Patokyo/blackjack-keychain/hardware/fabrication/blackjack-keychain.csv

Id | Designator | Footprint | Quantity | Designation | Supplier and ref
1 | C1, C2, C3 | C_1206_3216Metric_Pad1.33x1.80mm_HandSolder | 3 | 100nf
2 | C4 | C_1206_3216Metric_Pad1.33x1.80mm_HandSolder | 1 | 10uf
3 | D1 | LED_1210_3225Metric_Pad1.42x2.65mm_HandSolder | 1 | pair
4 | D2 | LED_1210_3225Metric_Pad1.42x2.65mm_HandSolder | 1 | soft
5 | D3 | LED_1210_3225Metric_Pad1.42x2.65mm_HandSolder | 1 | win
6 | D4 | LED_1210_3225Metric_Pad1.42x2.65mm_HandSolder | 1 | lose
7 | D5 | LED_1210_3225Metric_Pad1.42x2.65mm_HandSolder | 1 | push
8 | D6 | LED_1210_3225Metric_Pad1.42x2.65mm_HandSolder | 1 | right
9 | D7 | LED_1210_3225Metric_Pad1.42x2.65mm_HandSolder | 1 | wrong
10 | J1 | USB_C_Receptacle_GCT_USB4125-xx-x-0190_6P_TopMnt_Horizontal | 1 | USB_C_Receptacle_PowerOnly_6P
11 | J2 | ISP_2x03_Pads | 1 | Conn_02x03_Odd_Even
12 | Q1, Q2, Q3, Q4 | SOT-23 | 4 | NPN
13 | R1, R2 | R_0805_2012Metric_Pad1.20x1.40mm_HandSolder | 2 | 5.1k
14 | R6, R7, R_RESET1 | R_0805_2012Metric_Pad1.20x1.40mm_HandSolder | 3 | 10k
15 | R16, R17, R18, R19, RHIT1 | R_0805_2012Metric_Pad1.20x1.40mm_HandSolder | 5 | 1k
16 | Ra1, Rb1, Rc1, RCORRECT1, Rd1, RDPX1, Re1, Rf1, Rg1, RINCORRECT1, RLOSE1, RPAIR1, RPUSH1, RSOFT1, RWIN1 | R_0805_2012Metric_Pad1.20x1.40mm_HandSolder | 15 | 330
17 | RBR1, RDOUBLE2 | R_0805_2012Metric_Pad1.20x1.40mm_HandSolder | 2 | 6.8k
18 | RSPLIT1 | R_0805_2012Metric_Pad1.20x1.40mm_HandSolder | 1 | 2.2k
19 | RSTAND1 | R_0805_2012Metric_Pad1.20x1.40mm_HandSolder | 1 | 3.3k
20 | SW1 | SW_Tactile_SPST_NO_Straight_CK_PTS636Sx25SMTRLFS | 1 | hit
21 | SW2 | SW_Tactile_SPST_NO_Straight_CK_PTS636Sx25SMTRLFS | 1 | stand
22 | SW3 | SW_Tactile_SPST_NO_Straight_CK_PTS636Sx25SMTRLFS | 1 | double
23 | SW4 | SW_Tactile_SPST_NO_Straight_CK_PTS636Sx25SMTRLFS | 1 | split
24 | SW5 | SW_Tactile_SPST_NO_Straight_CK_PTS636Sx25SMTRLFS | 1 | bank
25 | SW6 | SW_SPDT_Shouhan_MSK12C02 | 1 | SW_SPDT
26 | U1 | TQFP-32_7x7mm_P0.8mm | 1 | ATmega328P-A
27 | U2 | 7_Segment_Display-4_bit-0.28Inch | 1 | CC56-12EWA
