Patokyo/blackjack-keychain/hardware/3dmodels/MSK12C02.step

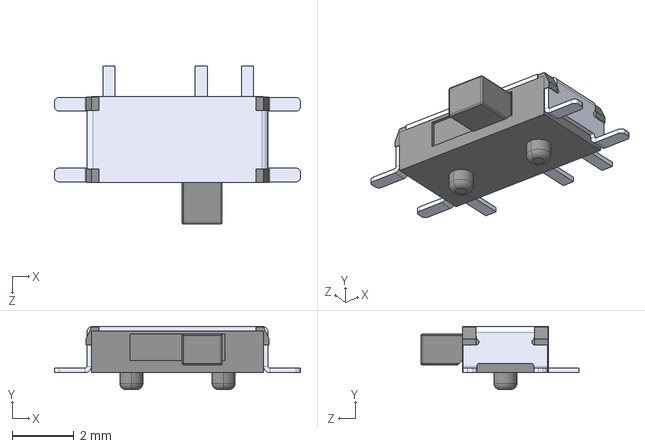
[picture p1: CAD file, 2026-11-04]
hardware/3dmodels/MSK12C02.step
8.00 x 2.05 x 5.15 mm
