Patokyo/blackjack-keychain/hardware/3dmodels/7seg_4digit_028in.step

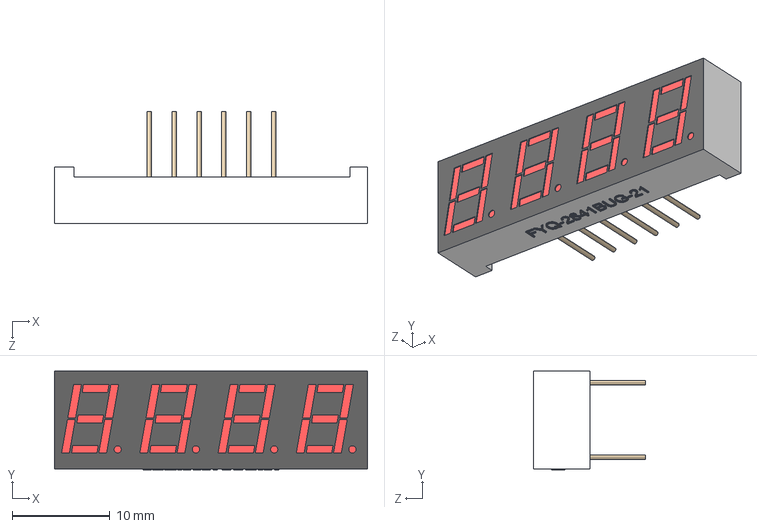
[picture p2: CAD file, 2026-11-04]
hardware/3dmodels/7seg_4digit_028in.step
32.0 x 10.1 x 11.5 mm
