Patokyo/blackjack-keychain/hardware/blackjack-keychain.kicad_pcb

## KiCad design hardware/blackjack-keychain.kicad_pcb (2026-11-06)

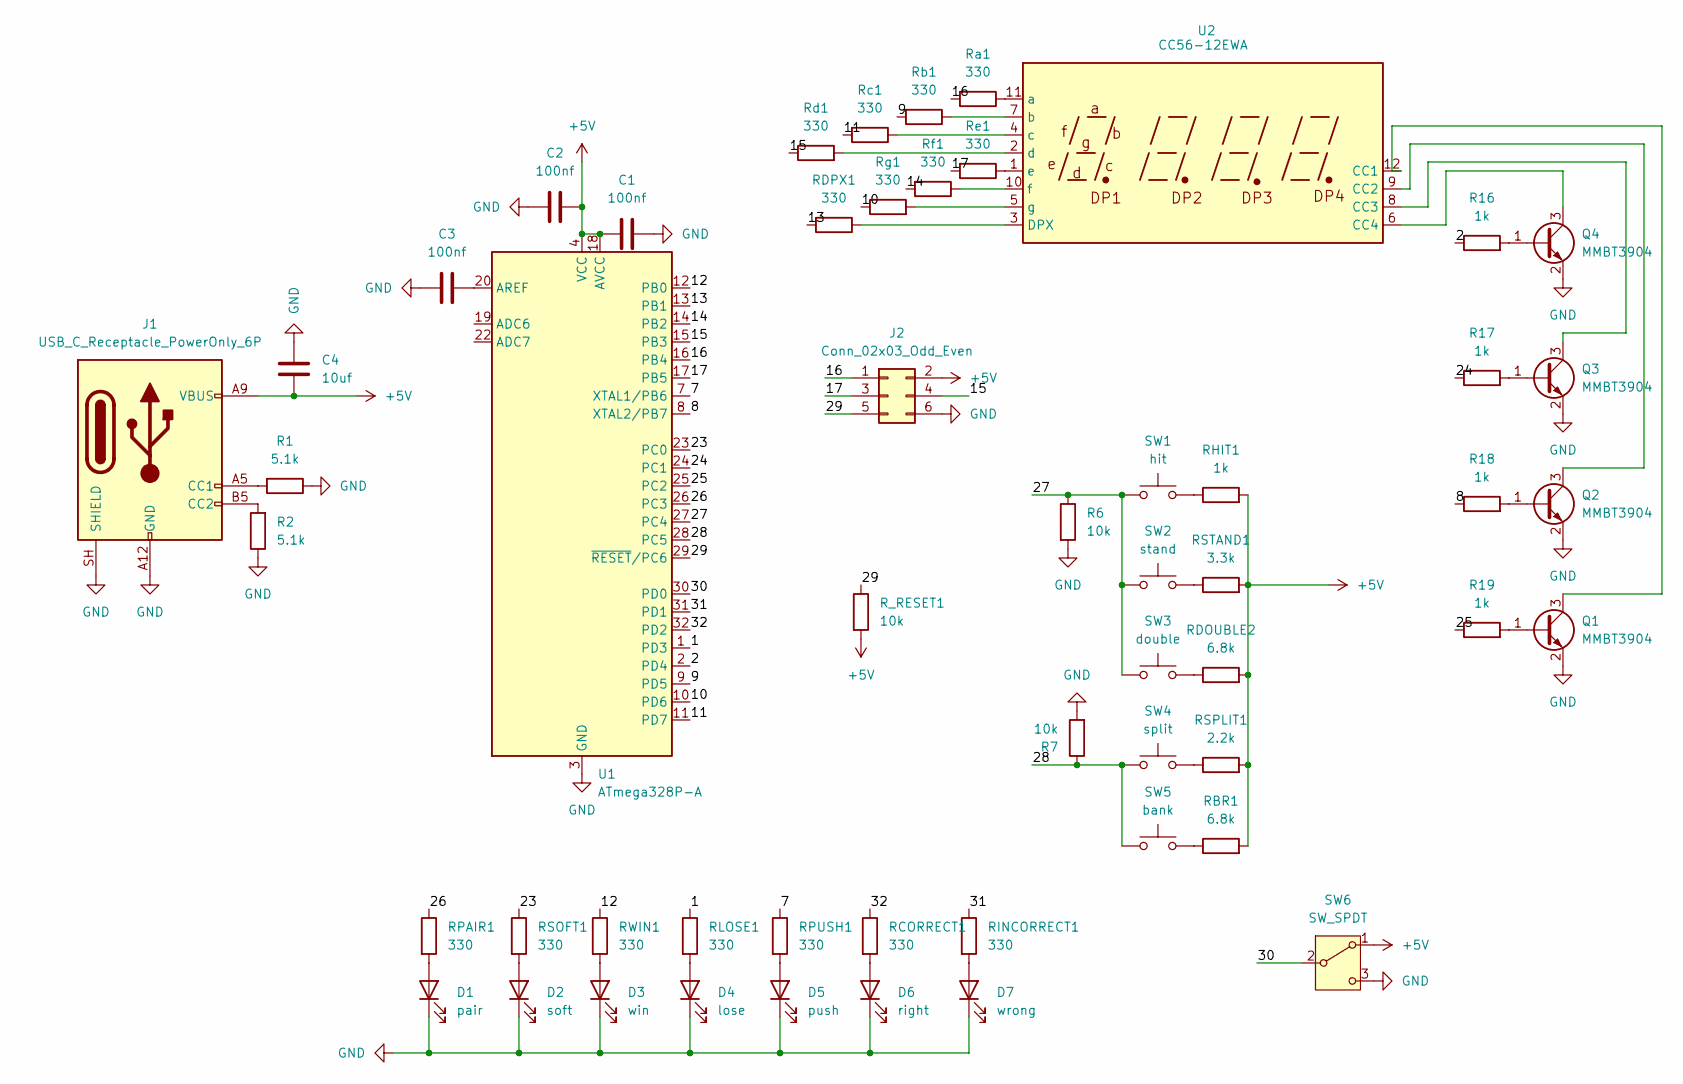
[picture p3: schematic blackjack-keychain.kicad_sch]

Parts:
C1, C2, C3: 100nf; C_0805_2012Metric_Pad1.18x1.45mm_HandSolder
C4: 10uf; C_0805_2012Metric_Pad1.18x1.45mm_HandSolder
D1: pair; LED_1210_3225Metric_Pad1.42x2.65mm_HandSolder
D2: soft; LED_1210_3225Metric_Pad1.42x2.65mm_HandSolder
D3: win; LED_1210_3225Metric_Pad1.42x2.65mm_HandSolder
D4: lose; LED_1210_3225Metric_Pad1.42x2.65mm_HandSolder
D5: push; LED_1210_3225Metric_Pad1.42x2.65mm_HandSolder
D6: right; LED_1210_3225Metric_Pad1.42x2.65mm_HandSolder
D7: wrong; LED_1210_3225Metric_Pad1.42x2.65mm_HandSolder
J1: USB_C_Receptacle_PowerOnly_6P; USB_C_Receptacle_GCT_USB4125-xx-x-0190_6P_TopMnt_Horizontal
J2: Conn_02x03_Odd_Even; ISP_2x03_Pads
Q1, Q2, Q3, Q4: MMBT3904; SOT-23
R1, R2: 5.1k; R_0805_2012Metric_Pad1.20x1.40mm_HandSolder
R6, R7: 10k; R_0805_2012Metric_Pad1.20x1.40mm_HandSolder
R16, R17, R18, R19: 1k; R_0805_2012Metric_Pad1.20x1.40mm_HandSolder
RBR1: 6.8k; R_0805_2012Metric_Pad1.20x1.40mm_HandSolder
RCORRECT1: 330; R_0805_2012Metric_Pad1.20x1.40mm_HandSolder
RDOUBLE2: 6.8k; R_0805_2012Metric_Pad1.20x1.40mm_HandSolder
RDPX1: 330; R_0805_2012Metric_Pad1.20x1.40mm_HandSolder
RHIT1: 1k; R_0805_2012Metric_Pad1.20x1.40mm_HandSolder
RINCORRECT1: 330; R_0805_2012Metric_Pad1.20x1.40mm_HandSolder
RLOSE1: 330; R_0805_2012Metric_Pad1.20x1.40mm_HandSolder
RPAIR1: 330; R_0805_2012Metric_Pad1.20x1.40mm_HandSolder
RPUSH1: 330; R_0805_2012Metric_Pad1.20x1.40mm_HandSolder
RSOFT1: 330; R_0805_2012Metric_Pad1.20x1.40mm_HandSolder
RSPLIT1: 2.2k; R_0805_2012Metric_Pad1.20x1.40mm_HandSolder
RSTAND1: 3.3k; R_0805_2012Metric_Pad1.20x1.40mm_HandSolder
RWIN1: 330; R_0805_2012Metric_Pad1.20x1.40mm_HandSolder
R_RESET1: 10k; R_0805_2012Metric_Pad1.20x1.40mm_HandSolder
Ra1: 330; R_0805_2012Metric_Pad1.20x1.40mm_HandSolder
Rb1: 330; R_0805_2012Metric_Pad1.20x1.40mm_HandSolder
Rc1: 330; R_0805_2012Metric_Pad1.20x1.40mm_HandSolder
Rd1: 330; R_0805_2012Metric_Pad1.20x1.40mm_HandSolder
Re1: 330; R_0805_2012Metric_Pad1.20x1.40mm_HandSolder
Rf1: 330; R_0805_2012Metric_Pad1.20x1.40mm_HandSolder
Rg1: 330; R_0805_2012Metric_Pad1.20x1.40mm_HandSolder
SW1: hit; SW_Tactile_SPST_NO_Straight_CK_PTS636Sx25SMTRLFS
SW2: stand; SW_Tactile_SPST_NO_Straight_CK_PTS636Sx25SMTRLFS
SW3: double; SW_Tactile_SPST_NO_Straight_CK_PTS636Sx25SMTRLFS
SW4: split; SW_Tactile_SPST_NO_Straight_CK_PTS636Sx25SMTRLFS
SW5: bank; SW_Tactile_SPST_NO_Straight_CK_PTS636Sx25SMTRLFS
SW6: SW_SPDT; SW_SPDT_Shouhan_MSK12C02
U1: ATmega328P-A; TQFP-32_7x7mm_P0.8mm
U2: CC56-12EWA; 7_Segment_Display-4_bit-0.28Inch

Connections:
+5V: C1.1, C2.1, C4.1, J1.A9 (VBUS), J1.B9 (VBUS), J2.2, RBR1.2, RDOUBLE2.2, RHIT1.2, RSPLIT1.2, RSTAND1.2, R_RESET1.2, SW6.1 (A), U1.4 (VCC), U1.6 (VCC), U1.18 (AVCC)
/1: RLOSE1.1, U1.1 (PD3)
/2: R16.1, U1.2 (PD4)
/7: RPUSH1.1, U1.7 (XTAL1/PB6)
/8: R18.1, U1.8 (XTAL2/PB7)
/9: Rb1.2, U1.9 (PD5)
/10: Rg1.1, U1.10 (PD6)
/11: Rc1.2, U1.11 (PD7)
/12: RWIN1.1, U1.12 (PB0)
/13: RDPX1.2, U1.13 (PB1)
/14: Rf1.2, U1.14 (PB2)
/15: J2.4, Rd1.1, U1.15 (PB3)
/16: J2.1, Ra1.2, U1.16 (PB4)
/17: J2.3, Re1.2, U1.17 (PB5)
/23: RSOFT1.1, U1.23 (PC0)
/24: R17.1, U1.24 (PC1)
/25: R19.1, U1.25 (PC2)
/26: RPAIR1.1, U1.26 (PC3)
/27: R6.1, SW1.1, SW2.1, SW3.1, U1.27 (PC4)
/28: R7.1, SW4.1, SW5.1, U1.28 (PC5)
/29: J2.5, R_RESET1.1, U1.29 (~RESET/PC6)
/30: SW6.2 (B), U1.30 (PD0)
/31: RINCORRECT1.1, U1.31 (PD1)
/32: RCORRECT1.1, U1.32 (PD2)
GND: C1.2, C2.2, C3.2, C4.2, D1.1 (K), D2.1 (K), D3.1 (K), D4.1 (K), D5.1 (K), D6.1 (K), D7.1 (K), J1.A12 (GND), J1.B12 (GND), J1.SH (SHIELD), J2.6, Q1.2 (E), Q2.2 (E), Q3.2 (E), Q4.2 (E), R1.1, R2.1, R6.2, R7.2, SW6.3 (C), U1.3 (GND), U1.5 (GND), U1.21 (GND)
unnamed: D1.2 (A), RPAIR1.2
unnamed: D2.2 (A), RSOFT1.2
unnamed: D3.2 (A), RWIN1.2
unnamed: D4.2 (A), RLOSE1.2
unnamed: D5.2 (A), RPUSH1.2
unnamed: D6.2 (A), RCORRECT1.2
unnamed: D7.2 (A), RINCORRECT1.2
unnamed: J1.A5 (CC1), R1.2
unnamed: J1.B5 (CC2), R2.2
unnamed: Q1.1 (B), R19.2
unnamed: Q1.3 (C), U2.12 (CC1)
unnamed: Q2.1 (B), R18.2
unnamed: Q2.3 (C), U2.9 (CC2)
unnamed: Q3.1 (B), R17.2
unnamed: Q3.3 (C), U2.8 (CC3)
unnamed: Q4.1 (B), R16.2
unnamed: Q4.3 (C), U2.6 (CC4)
unnamed: RBR1.1, SW5.2
unnamed: RDOUBLE2.1, SW3.2
unnamed: RHIT1.1, SW1.2
unnamed: RSPLIT1.1, SW4.2
unnamed: RSTAND1.1, SW2.2
unnamed: C3.1, U1.20 (AREF)
unnamed: RDPX1.1, U2.3 (DPX)
unnamed: Ra1.1, U2.11 (a)
unnamed: Rb1.1, U2.7 (b)
unnamed: Rc1.1, U2.4 (c)
unnamed: Rd1.2, U2.2 (d)
unnamed: Re1.1, U2.1 (e)
unnamed: Rf1.1, U2.10 (f)
unnamed: Rg1.2, U2.5 (g)

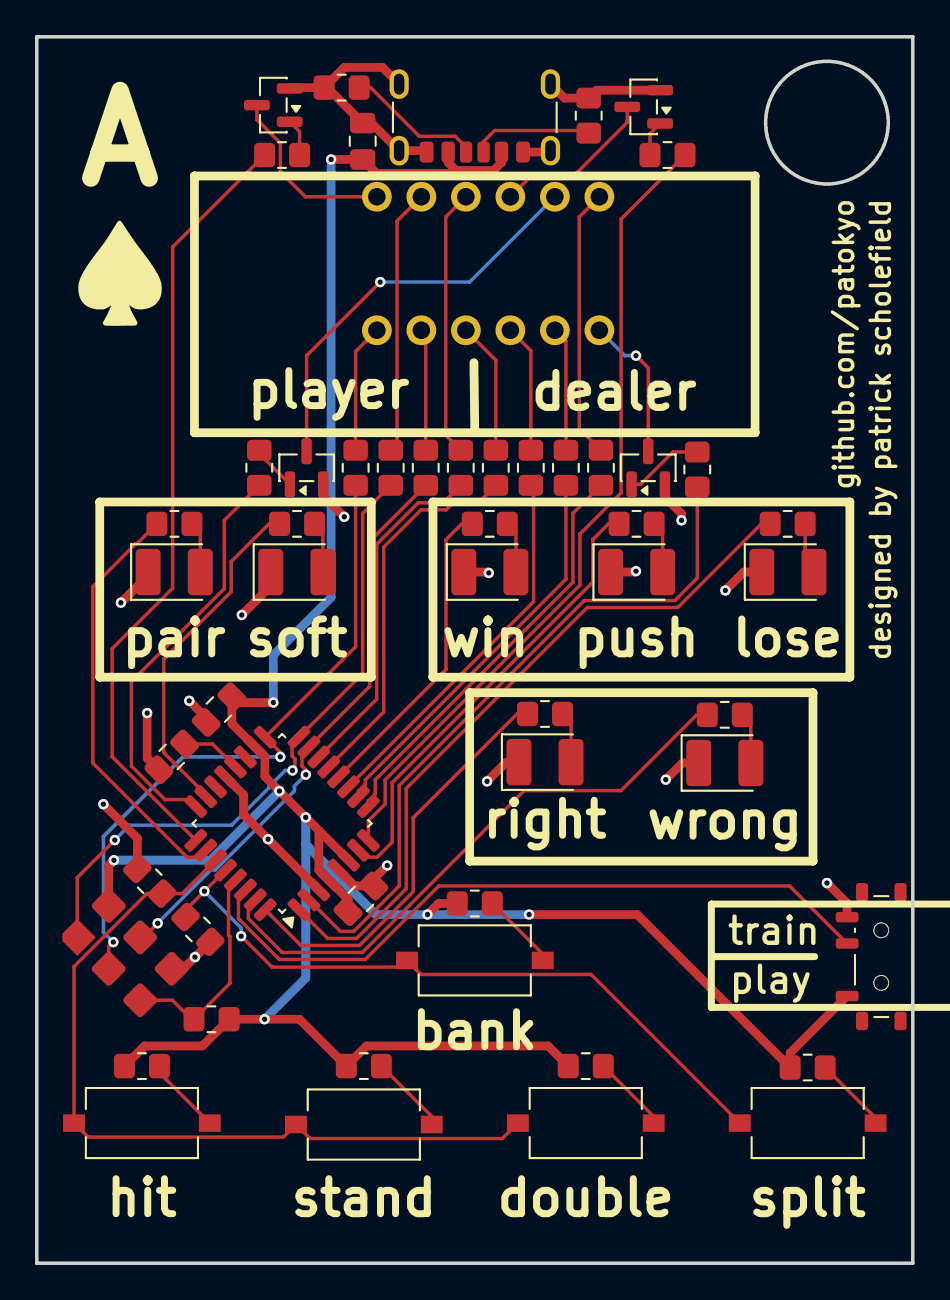
[picture p4: board blackjack-keychain.kicad_pcb from above]

Board: 2 copper layers, 50.0 x 70.0 mm, 54 parts (0 on the bottom side), 56 nets.
