Patokyo/blackjack-keychain/(commit log)

2026-11-03 Group the KiCad project and firmware into a documented layout
    Split the repo into hardware/ (project plus fabrication outputs), firmware/ and add a README, and stop tracking KiCad autosaves, backups, lock files and project-local settings so only sources and released outputs are versioned.
    [blackjack-keychain-B_Cu.gbr, blackjack-keychain-B_Mask.gbr, blackjack-keychain-B_Paste.gbr, blackjack-keychain-B_Silkscreen.gbr, blackjack-keychain-Edge_Cuts.gbr, blackjack-keychain-F_Cu.gbr, blackjack-keychain-F_Mask.gbr, blackjack-keychain-F_Paste.gbr]
2026-11-04 added caps and rerouted pcb
    [blackjack-keychain.kicad_pcb, blackjack-keychain.kicad_sch]
2026-11-04 Vendor the custom footprint library with the project
    The display and ISP pad footprints only existed in the global KiCad
    library on one machine, so a clone could not resolve the board's
    footprint links. Commit both footprints under hardware/ and add a
    project fp-lib-table that points at them via KIPRJMOD.
2026-11-04 Vendor the display and slide-switch STEP models and reroute the PCB
    Attach the local 3D models to the 7-segment footprint and the switch, fixing
    the switch model rotation/offset, and reroute the power and segment nets that
    moved with the updated layout.
    [7seg_4digit_028in.step, MSK12C02.step, blackjack-keychain.kicad_pcb]
2026-11-04 added 10k pullup to reset
    [blackjack-keychain.csv, blackjack-keychain.kicad_pcb, blackjack-keychain.kicad_sch]
2026-11-06 worked on pcb
    [blackjack-keychain.kicad_pcb, blackjack-keychain.kicad_sch]
2026-11-06 Regenerate the fabrication outputs from the current board
    The committed plots predated the final routing: B.Cu was missing the ground
    pour entirely and the digit-drive assignment had changed since they were
    exported, so the release zip did not describe the board that was verified.
    Re-export every layer, both drill files and the job file, and repackage them
    under hardware/fabrication/.
    [blackjack-keychain-B_Cu.gbr, blackjack-keychain-B_Mask.gbr, blackjack-keychain-B_Paste.gbr, blackjack-keychain-B_Silkscreen.gbr, blackjack-keychain-Edge_Cuts.gbr, blackjack-keychain-F_Cu.gbr, blackjack-keychain-F_Mask.gbr, blackjack-keychain-F_Paste.gbr]
2026-11-06 ordered pcbs ahhh
    [blackjack-keychain-B_Cu.gbr, blackjack-keychain-B_Mask.gbr, blackjack-keychain-B_Paste.gbr, blackjack-keychain-B_Silkscreen.gbr, blackjack-keychain-Edge_Cuts.gbr, blackjack-keychain-F_Cu.gbr, blackjack-keychain-F_Mask.gbr, blackjack-keychain-F_Paste.gbr]
2026-11-07 Add a browser version of the blackjack keychain
    Port the firmware's 6-deck shoe, S17/DAS rules and basic-strategy table to
    virtual/ so the keychain can be played on a local page: four digits with
    player on the left and dealer on the right, the seven LEDs, the four action
    buttons plus bank, and the train/play slide switch. Hands advance on their
    own after each result, the way the sketch does.
2026-11-07 Draw the virtual board from the PCB, in blue or red
    The browser version now shows the plotted board instead of a generic
    device: silkscreen, pads, drills and part outlines come from the
    fabrication gerbers and the board file, with the display, LEDs, buttons
    and switch overlaid where they sit on the board.
    The board art is generated per soldermask colour, so the page can offer
    blue or red. Re-run virtual/make_board.py after re-plotting to refresh
    board-blue.svg and board-red.svg.
2026-11-07 Publish the virtual board with GitHub Pages
    The workflow uploads virtual/ as the site root whenever main changes it,
    so the demo is served at the repository's Pages URL without a /virtual
    path and without publishing the board files.
2026-11-07 Brighten the LEDs and stop long presses selecting the board
    A lit LED is now a hotter white centre over the board colour, with the
    glow added to the pixels underneath (plus-lighter, screen where that is
    unsupported) and a wider halo, so it still reads on a bright phone
    screen instead of washing out.
    The board and its keys also opt out of text selection, the image copy
    callout and draggable art, and the board swallows the context menu, so
    holding a key on a phone presses it rather than offering to copy the
    artwork.
2026-11-07 Draw the copper traces under the solder mask
    The front copper layer is plotted with the rest of the board now, so the
    routing shows through the mask the way it does on the real thing. Each
    trace gets a dark gutter, the copper itself and a thin highlight along
    the top of the bump, tinted per mask colour, and sits under the pads and
    silkscreen.
2026-11-07 Port the sketch's rules and timing to the virtual board
    The browser version had drifted from the firmware: it counted dollars
    instead of cents, paid a natural even money instead of 3:2, refused to
    play a bank under $10, and treated a 21 after any split as a natural.
    Now the money, the short bet, the 3:2 payout, the $9999 jackpot and the
    newcomer restart all come from the sketch, and a split hand can no
    longer make a natural.
    The display follows it too: one segment buffer with the decimal point,
    HIGH and the best bank on entering play, action words for a wrong call,
    the two blink rejects, the blinking summary, the bank button that takes
    the display over while held and flashes HIGH past a sec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
2026-11-13 Run the game on a Nano, with pair and soft on real pins
    The keychain's 22-pin budget does not fit the Nano's 20 usable pads,
    so the button ladders move to the ADC-only A6/A7, freeing A4/A5, and
    the correct and wrong grading lamps stay as empty hooks while pair
    and soft get D2 and D3. Both digit 2 and push now go through plain
    digitalWrite, so no PORTB bit twiddling is left.
    🤖 Generated with Codebuff
    [nano-blackjack.ino]
